Emanuel624/Bitacora_proyectofunda1_ECH_FFM/(list of files, drawings)

Other design files:
sim_proyecto1/decodificadores.circ
sim_proyecto1/serializador.circ
