Emanuel624/Bitacora_proyectofunda1_ECH_FFM/(commit log)

2025-09-07 Avances en la bitacora.
2025-09-09 Se añaden archivos de simulación de logisim-evolution
    Se añade el archivo con los decodificadores
    Se añade el archivo con el serializador
    [decodificadores.circ, serializador.circ]
2025-09-10 Actualización de la bitácora
    Actualización de la bitácora 9 setiembre 2025
2025-09-18 Cambios bitacora (semi_final)
    Se cambia la bitácora para estar mas acorde con la rubrica.
2025-09-18 Se añade el enlace el enlace al pdf
    cambios al pdf finales para la entrega del taller.
2025-09-27 Cambios bitácora y documentos de simulación
    [decodificadores.circ]
2025-09-27 Cambios pre-finales
    Se necesita aclarar dudas sobre una de los aspectos de la rubrico de la bitácora con el profesor.
2025-09-27 Cambios a la última sesión de trabajo
2025-09-30 Se cambia el nombre de la carpeta.
    [decodificadores.circ, serializador.circ]
